neon-beat/neon-beat-buzzer-pcb/3d_views/User Library-VQFN 16-Pin 0_5mm Pitch RVA (S-PVQFN-N16).step

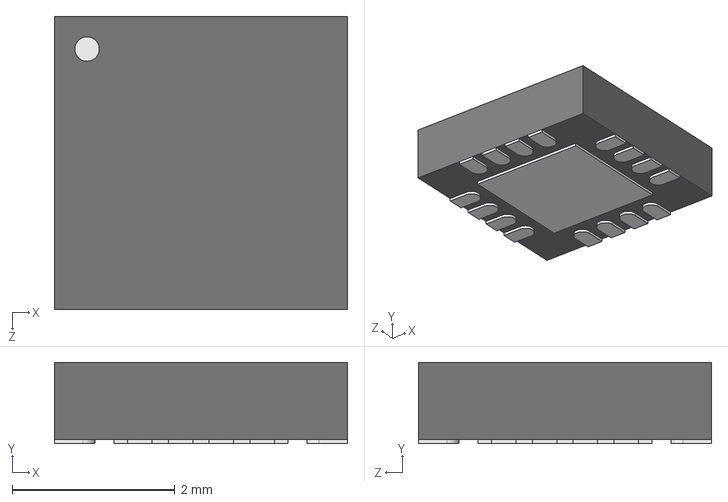
[picture p1: CAD file, 2026-04-05]
3d_views/User Library-VQFN 16-Pin 0_5mm Pitch RVA (S-PVQFN-N16).step
3.60 x 1.00 x 3.60 mm
