neon-beat/neon-beat-buzzer-pcb/3d_views/0530480260.stp

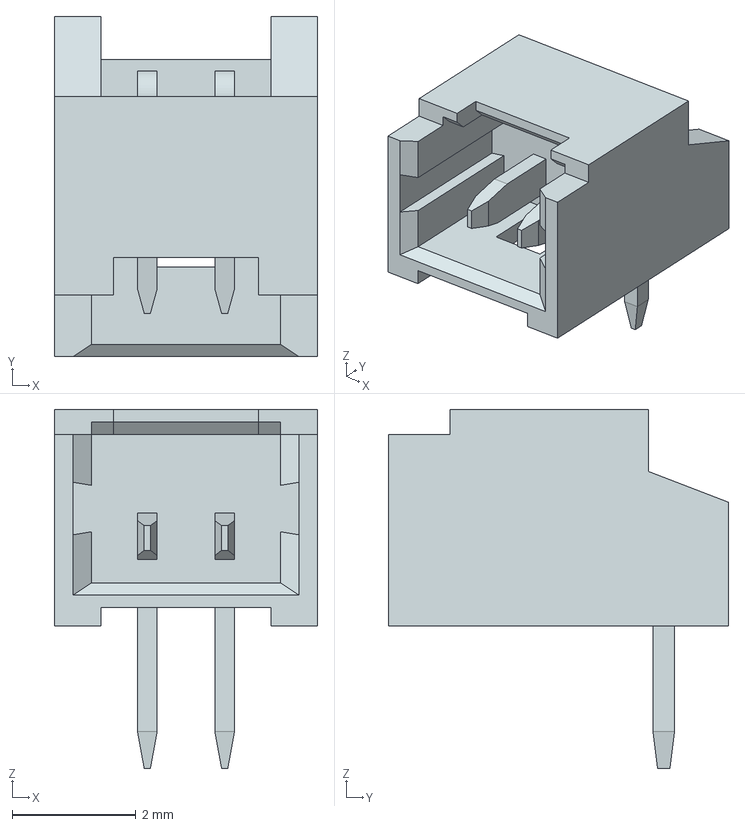
[picture p2: CAD file, 2026-04-05]
3d_views/0530480260.stp
4.25 x 5.50 x 5.80 mm
