neon-beat/neon-beat-buzzer-pcb/(list of files, cad)

Other CAD files:
edge_cut.FCStd
