neon-beat/neon-beat-buzzer-pcb/neon-beat-buzzer-pcb.kicad_pcb

## KiCad design neon-beat-buzzer-pcb.kicad_pcb (2026-05-10)

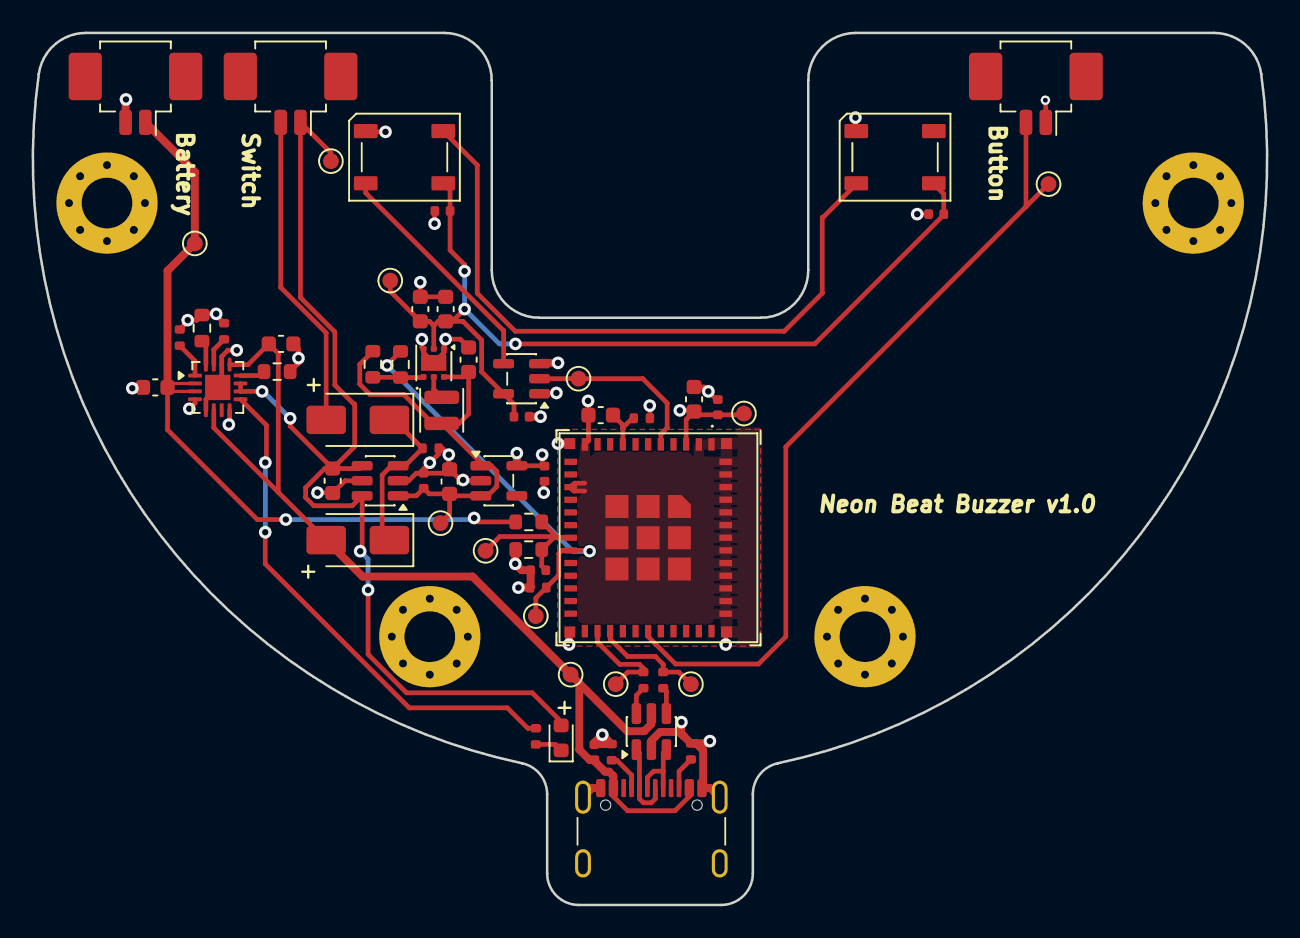
[picture p3: board neon-beat-buzzer-pcb.kicad_pcb from above]

Board: 4 copper layers, 78.0 x 55.1 mm, 66 parts (0 on the bottom side), 32 nets.

Parts:
C1: 4.7uF; C_0603_1608Metric
C2, C3, C11, C14: 1uF; C_0603_1608Metric
C4, C5, C6, C9: 10uF; C_0603_1608Metric
C7, C10: 100nF; C_0402_1005Metric
C8, C12, C13, C15, C16, C17: 0.1uF; C_0402_1005Metric
D3, D4: WS2812B; LED_WS2812B_PLCC4_5.0x5.0mm_P3.2mm
D5: LED; LED_0603_1608Metric
D7, D8: D_Schottky; D_SMA
H1, H2, H3, H4: MountingHole_3.2mm_M3_Pad_Via
J1: BATT_CON; Molex_PicoBlade_53261-0271_1x02-1MP_P1.25mm_Horizontal
J2: SWITCH_CON; Molex_PicoBlade_53261-0271_1x02-1MP_P1.25mm_Horizontal
J3: BUTTON_CON; Molex_PicoBlade_53261-0271_1x02-1MP_P1.25mm_Horizontal
J4: USB_C_Receptacle_USB2.0_16P; USB_C_Receptacle_GCT_USB4105-xx-A_16P_TopMnt_Horizontal
L1: 2.2uH; L_APV_ANR252010
R1, R2: 5.1k; R_0402_1005Metric
R3, R4: 22; R_0402_1005Metric
R5, R9, R15, R16: 10k; R_0402_1005Metric
R6: 1.8k; R_0603_1608Metric
R7: 3k; R_0603_1608Metric
R8: 1k; R_0402_1005Metric
R10: 68k; R_0603_1608Metric
R11: 220k; R_0603_1608Metric
R12: 1.5k; R_0402_1005Metric
R13, R14: 0; R_0603_1608Metric
TP1, TP2, TP3, TP4, TP5, TP6, TP7, TP8, TP9, TP10, TP11, TP12: TestPoint_Pad_D1.0mm
U1: ESP32-C3-MINI-1; ESP32-C3-MINI-1U
U2: BQ24074RGT; VQFN-16-1EP_3x3mm_P0.5mm_EP1.6x1.6mm
U3: TPS22929D; SOT-23-6
U4: 74AHCT1G125; SOT-23-5
U5: TPS610997DRV; WSON-6-1EP_2x2mm_P0.65mm_EP1x1.6mm
U6: USBLC6-2SC6; SOT-23-6
U7: XC6210B332MR; SOT-23-5

Connections:
/boost_en: R13.1, R16.1, TP12.1 (1_1), U1.19 (GPIO5/ADC2_CH0)
/button: J3.2, TP10.1 (1_1), U1.30 (GPIO20/U0RXD)
/chg: R12.2, U2.9 (~CHG)
/esp_usb_dm: R4.2, TP8.1 (1_1), U1.26 (GPIO18/USB_D-)
/esp_usb_dp: R3.2, TP7.1 (1_1), U1.27 (GPIO19/USB_D+)
/led: TP9.1 (1_1), U1.5 (GPIO2/ADC1_CH2), U4.2
/switch: D7.2 (A), J2.2
/v_3v3: C8.1, C9.1, C13.1, J3.1, R9.2, TP5.1 (1_1), U1.3 (3V3), U7.5 (VOUT)
/v_5v: C5.1, C6.1, C15.1, C16.1, C17.1, D3.1 (VDD), D4.1 (VDD), TP6.1 (1_1), U4.5 (VCC), U5.2 (VOUT)
/v_batt_meas: C7.1, R10.1, R11.2, TP11.1 (1_1), U1.18 (GPIO4/ADC1_CH4)
/v_batt_p: C1.1, J1.1, R11.1, TP1.1 (1_1), U2.2 (BAT), U2.3 (BAT)
/v_ldo: C4.1, C12.1, C14.1, L1.2, R14.2, TP4.1 (1_1), U3.1 (VOUT), U5.6 (VI), U7.1 (VIN), U7.3 (CE)
/v_sys: C11.1, D5.2 (A), J2.1, TP2.1 (1_1), U2.10 (OUT), U2.11 (OUT), U3.4 (VIN), U3.6 (VIN)
/v_usb: C2.1, C10.1, D8.2 (A), J4.A4 (VBUS), J4.A9 (VBUS), J4.B4 (VBUS), J4.B9 (VBUS), TP3.1 (1_1), U2.6 (EN1), U2.13 (IN), U6.5 (VBUS)
GND: C1.2, C2.2, C3.2, C4.2, C5.2, C6.2, C7.2, C8.2, C9.2, C10.2, C11.2, C12.2, C13.2, C14.2, C15.2, C16.2, C17.2, D3.3 (VSS), D4.3 (VSS), H1.1 (1_1), H2.1 (1_1), H3.1 (1_1), H4.1 (1_1), J1.2, J4.A1 (GND), J4.A12 (GND), J4.B1 (GND), J4.B12 (GND), J4.SH (SHIELD), R1.2, R2.2, R5.1, R6.1, R7.2, R8.2, R10.2, R15.2, R16.2, U1.1 (GND), U1.2 (GND), U1.11 (GND), U1.14 (GND), U1.36 (GND), U1.37 (GND), U1.38 (GND), U1.39 (GND), U1.40 (GND), U1.41 (GND), U1.42 (GND), U1.43 (GND), U1.44 (GND), U1.45 (GND), U1.46 (GND), U1.47 (GND), U1.48 (GND), U1.49 (GND), U1.50 (GND), U1.51 (GND), U1.52 (GND), U1.53 (GND), U2.4 (~CE), U2.5 (EN2), U2.8 (VSS), U2.14 (TMR), U2.17 (VSS), U3.2 (GND), U3.5 (GND), U4.1, U4.3 (GND), U5.1 (GND), U5.3 (FB), U5.7 (GND), U6.2 (GND), U7.2 (GND)
unnamed: D3.4 (DIN), U4.4
unnamed: D3.2 (DOUT), D4.4 (DIN)
unnamed: D5.1 (K), R12.1
unnamed: D7.1 (K), D8.1 (K), R15.1, U3.3 (ON)
unnamed: J4.A5 (CC1), R1.1
unnamed: J4.B5 (CC2), R2.1
unnamed: J4.A6 (D+), J4.B6 (D+), U6.3 (I/O2)
unnamed: J4.A7 (D-), J4.B7 (D-), U6.1 (I/O1)
unnamed: R3.1, U6.4 (I/O2)
unnamed: R4.1, U6.6 (I/O1)
unnamed: C3.1, R9.1, U1.8 (EN/CHIP_PU)
unnamed: R7.1, U2.12 (ILIM)
unnamed: R6.2, U2.16 (ISET)
unnamed: R8.1, U2.15 (ITERM)
unnamed: R5.2, U2.1 (TS)
unnamed: R13.2, R14.1, U5.4 (EN)
unnamed: L1.1, U5.5 (SW)
