neon-beat/neon-beat-buzzer-pcb/(commit log)

2026-03-21 Initial import
    [neon-beat-buzzer-pcb.kicad_pcb, neon-beat-buzzer-pcb.kicad_sch]
2026-03-22 Add main features for the PCB Still missing: - battery measure - charging LED
    [neon-beat-buzzer-pcb.kicad_sch]
2026-03-23 schematic: all main features are now on-board
    [neon-beat-buzzer-pcb.kicad_sch]
2026-03-23 schematic: fix a handful of issues
    - invert usb signals
    - set power supply on power input pins
    - adjust battery measure divider to fit 1.1v ADC full scale
    - add decoupling capacitors on MCU
    [neon-beat-buzzer-pcb.kicad_sch]
2026-03-25 schematic: add esd protection, and add all footprints
    [neon-beat-buzzer-pcb.kicad_sch]
2026-03-26 pcb: move all composents in proper place
    [neon-beat-buzzer-pcb.kicad_pcb, neon-beat-buzzer-pcb.kicad_sch]
2026-03-30 pcb: add layout from Freecad
    [edge_cut.FCStd, neon-beat-buzzer-pcb.kicad_pcb]
2026-03-30 schematic: fix multiple points
    - use a LDO with lower drop
    - feed the boost directly with v_sys
    - add a few caps around WS2812 leds
    - fix mistake on the boost enable pin
    [neon-beat-buzzer-pcb.kicad_sch]
2026-03-30 project: partial routing
    [neon-beat-buzzer-pcb.kicad_pcb, neon-beat-buzzer-pcb.kicad_sch]
2026-04-05 3d: add missing 3d views
    Add 3d models for molex connector and battery charger
    [0530480260.stp, User Library-VQFN 16-Pin 0_5mm Pitch RVA (S-PVQFN-N16).step]
2026-04-05 pcb: add updated edge cut
    [edge_cut.FCStd]
2026-04-05 gitignore: ignore board step file
2026-04-05 project: add routed board
    - Board is now fully routed (and needs some review)
    - Tooling holes are added
    - Needs to complete BOM
    [neon-beat-buzzer-pcb.kicad_pcb, neon-beat-buzzer-pcb.kicad_sch]
2026-05-03 pcb: a few adjustments
    Mostly setting a few power sources on the schematic
    [neon-beat-buzzer-pcb.kicad_sch]
2026-05-10 board: fix layout
    Move the boost input from v_sys to v_ldo. Update the PCB accordingly.
    While at it, import JLCPCB design rules. There are still a lot of
    silkscreen clearance issues to fix.
    [neon-beat-buzzer-pcb.kicad_pcb, neon-beat-buzzer-pcb.kicad_sch]
2026-05-10 pcb: fix all DRC errors
    Many components had some silkscreen clearance issue regarding JLCPCB
    constraints. Fixed those by:
    - editing the library footprint
    - duplicating the footprint into a user library
    - removing the faulty silkscreen
    - updating all components using this footprint with the override one
    - re-hiding any additional silkscreen brought by the component update
    [neon-beat-buzzer-pcb.kicad_pcb]
